flipdot/door/hardware/pihat_door.kicad_pcb

## KiCad design hardware/pihat_door.kicad_pcb (2018-01-24)

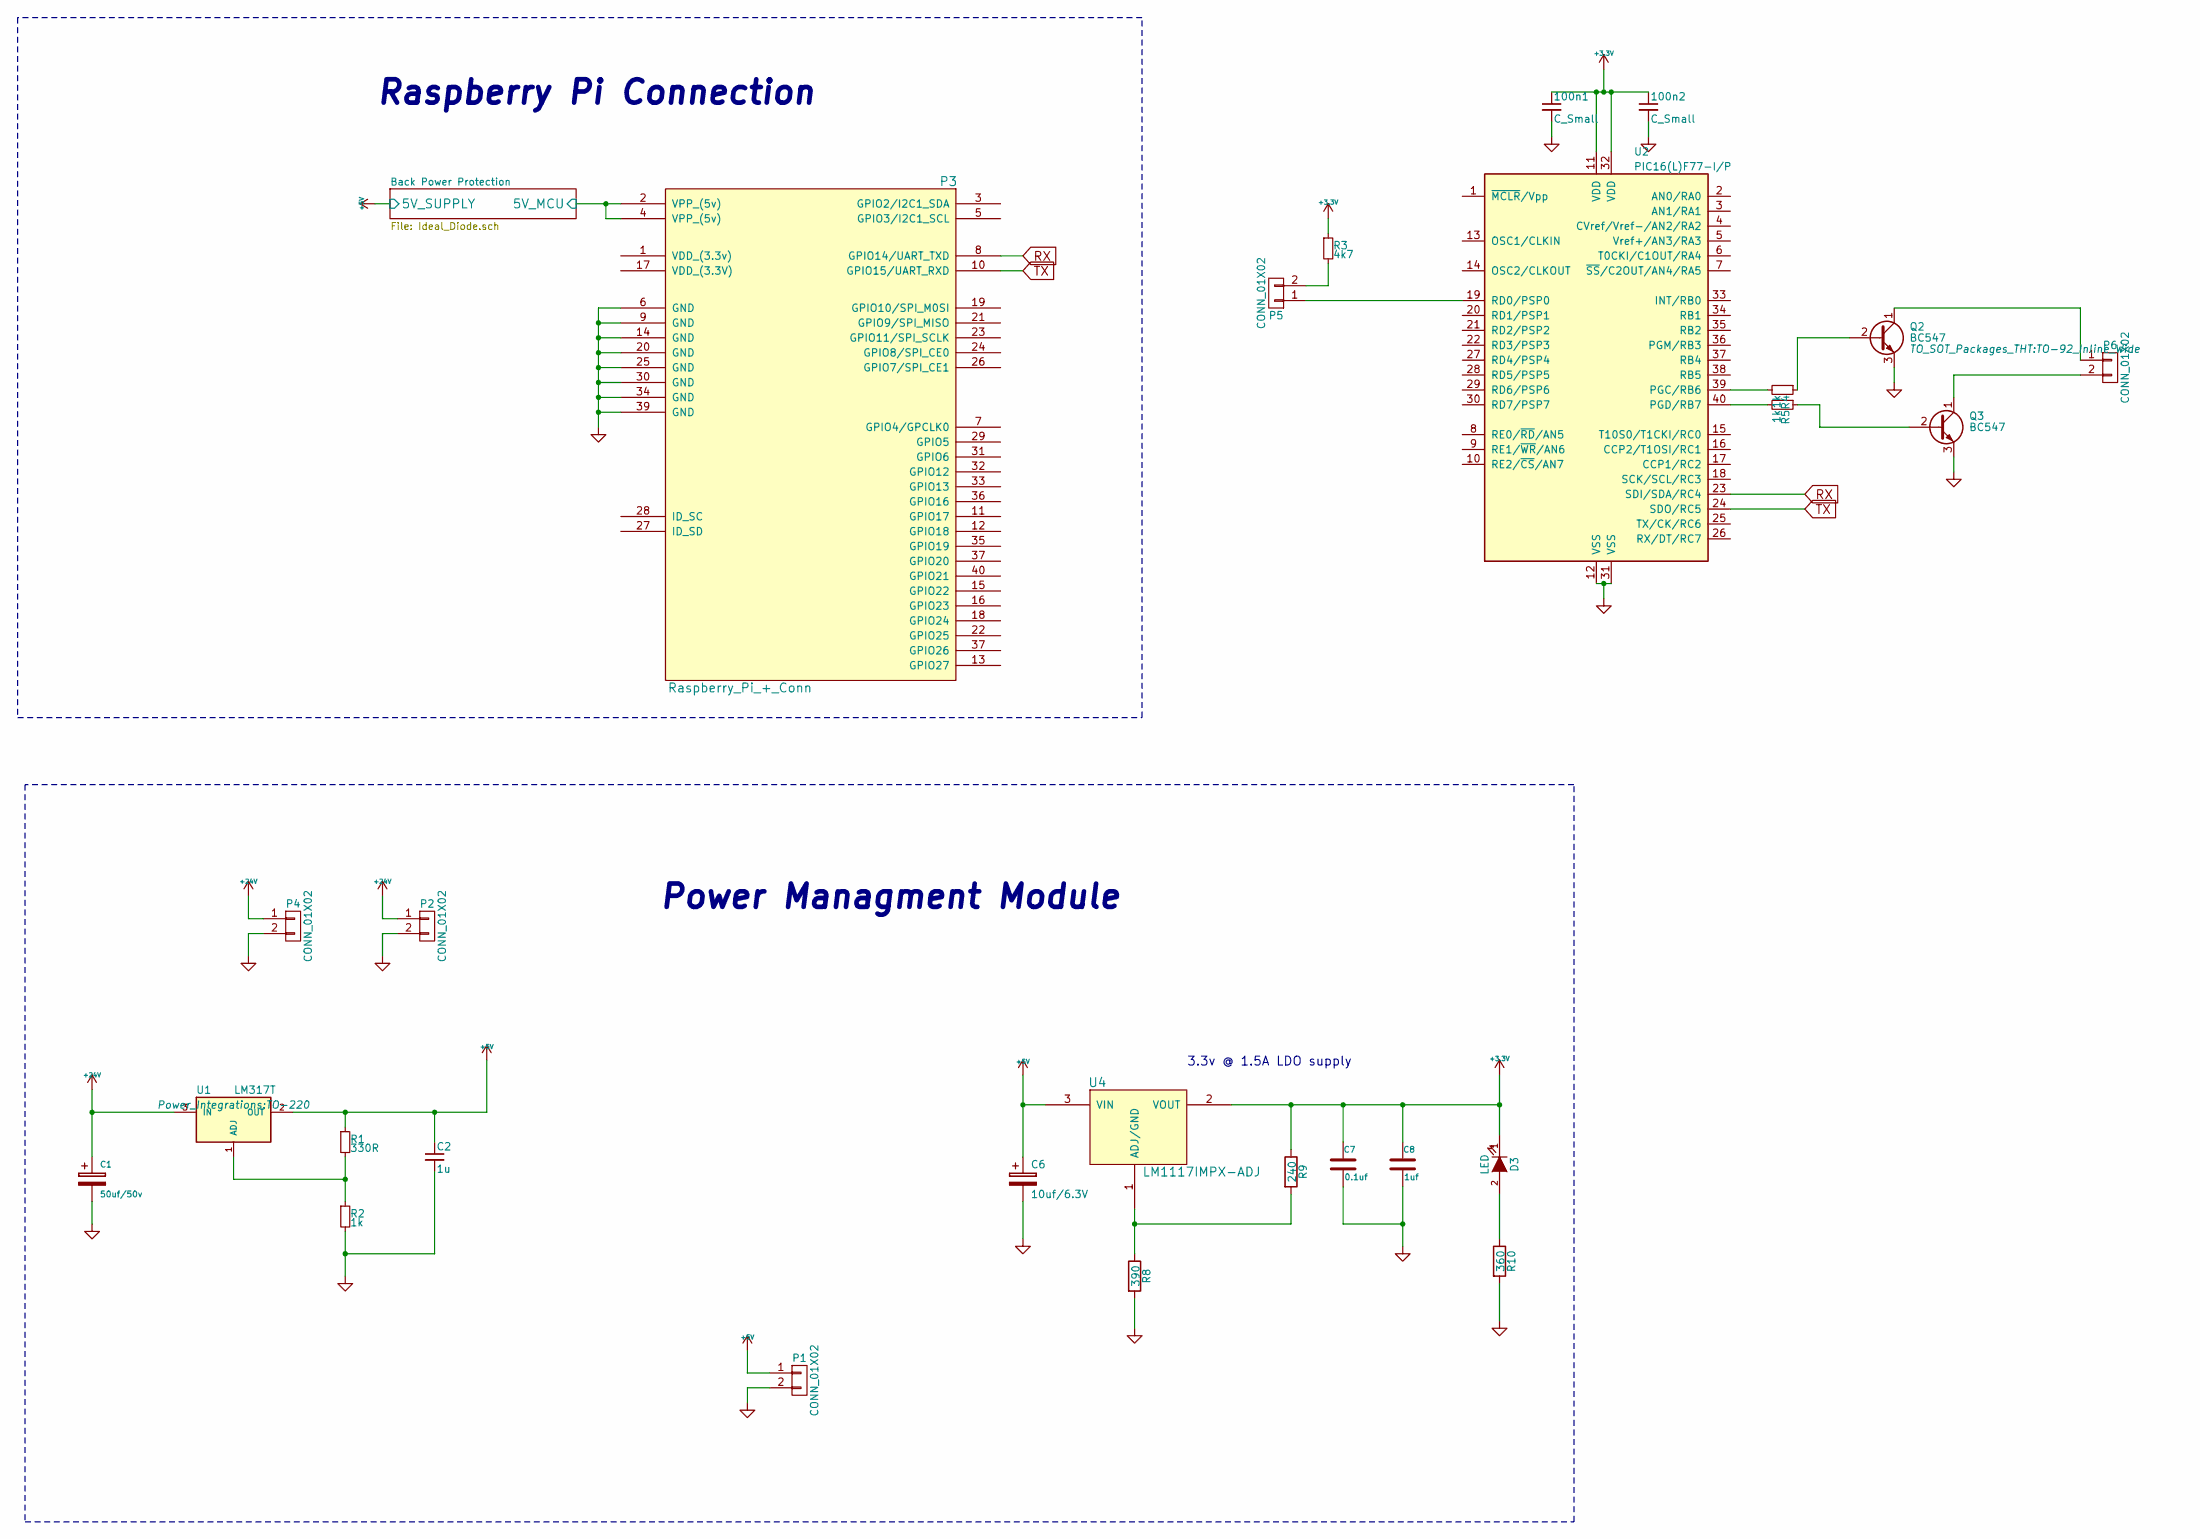
[picture p1: schematic pihat_door.sch]

Parts:
100n1, 100n2: C_Small; C_0805_HandSoldering
C1: 50uf/50v; c_elec_6.3x7.7; Mouser Part No. 647-UUR1H470MCL6GS
C2: 1u; c_elec_6.3x7.7
C6: 10uf/6.3V; c_elec_6.3x7.7; Mouser Part No. 5985-AVS16V100-F
C7: 0.1uf; C_0805_HandSoldering; Mouser Part No. 810-C1005X5R1H104K
C8: 1uf; C_0805_HandSoldering; Mouser Part No. 810-C1005X5R1H104K
D3: LED; LED-3MM; Mouser Part No. 743-HT-191USD
P1, P5, P6: CONN_01X02; AK300-2
P2, P4: CONN_01X02; PINHEAD1-2; Mouser Part No. 651-1904383
P3: Raspberry_Pi_+_Conn; IDC_Header_Straight_40pins; Mouser Part No. 517-30340-6002
Q2, Q3: BC547; TO-92_Inline_Wide
R1: 330R; R_0805_HandSoldering
R2, R4, R5: 1k; R_0805_HandSoldering
R3: 4k7; R_0805_HandSoldering
R8: 390; R_0805_HandSoldering; Mouser Part No. 594-MCT06030C3900FP5
R9: 240; R_0805_HandSoldering; Mouser Part No. 754-RR0816P-241D
R10: 360; R_0805_HandSoldering; Mouser Part No. 71-CRCW0603316RFKEB
U1: LM317T; TO-220
U2: PIC16(L)F77-I/P; DIP-40_W15.24mm
U4: LM1117IMPX-ADJ; TO-220; Mouser Part No. 926-M1117IMPXADJNOPB

Connections:
+3V3: 100n1.1, 100n2.1, C7.1, C8.1, D3.1 (K), R3.1, R9.1, U2.11 (VDD), U2.32 (VDD), U4.2 (VOUT)
+5V: C2.1, C6.1, P1.1, R1.1, U1.2 (OUT), U4.3 (VIN); also elsewhere on the board
+24V: C1.1, P2.1, P4.1, U1.3 (IN)
/Back Power Protection/5V_MCU: P3.2 (VPP_(5v)), P3.4 (VPP_(5v)); also elsewhere on the board
GND: 100n1.2, 100n2.2, C1.2, C2.2, C6.2, C7.2, C8.2, P1.2, P2.2, P3.6 (GND), P3.9 (GND), P3.14 (GND), P3.20 (GND), P3.25 (GND), P3.30 (GND), P3.34 (GND), P3.39 (GND), P4.2, Q2.3 (E), Q3.3 (E), R2.2, R8.2, R10.2, U2.12 (VSS), U2.31 (VSS); also elsewhere on the board
unnamed: D3.2 (A), R10.1
unnamed: P5.1, U2.19 (RD0/PSP0)
unnamed: P5.2, R3.2
unnamed: P6.1, Q2.1 (C)
unnamed: P6.2, Q3.1 (C)
unnamed: Q2.2 (B), R4.1
unnamed: Q3.2 (B), R5.1
unnamed: R1.2, R2.1, U1.1 (ADJ)
unnamed: R4.2, U2.39 (PGC/RB6)
unnamed: R5.2, U2.40 (PGD/RB7)
unnamed: R8.1, R9.2, U4.1 (ADJ/GND)
RX: P3.8 (GPIO14/UART_TXD), U2.23 (SDI/SDA/RC4)
TX: P3.10 (GPIO15/UART_RXD), U2.24 (SDO/RC5)

Notes on the sheet:
Raspberry Pi Connection
Power Managment Module
3.3v @ 1.5A LDO supply

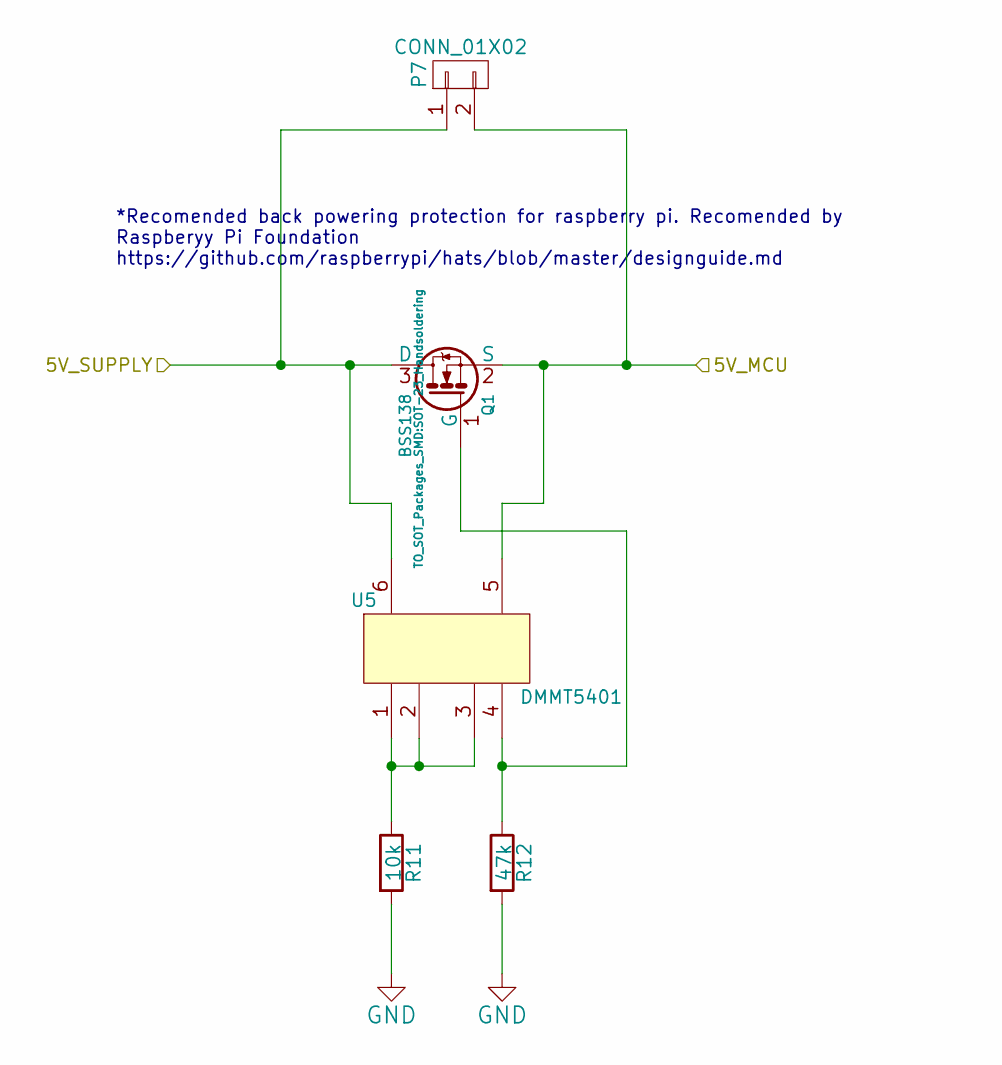
[picture p2: schematic Ideal_Diode.sch]

Parts:
P7: CONN_01X02; PINHEAD1-2
Q1: BSS138; SOT-23_Handsoldering; Mouser Part No. 621-DMG2305UX-13
R11: 10k; R_0805_HandSoldering; Mouser Part No. 71-CRCW0402-10K-E3
R12: 47k; R_0805_HandSoldering; Mouser Part No. 667-ERJ-2RKF4702X
U5: DMMT5401; SOT-23-6; Mouser Part No. 621-DMMT5401-7-F

Connections:
+5V: P7.1, Q1.3 (D), U5.6; also elsewhere on the board
/Back Power Protection/5V_MCU: P7.2, Q1.2 (S), U5.5; also elsewhere on the board
GND: R11.2, R12.2; also elsewhere on the board
unnamed: Q1.1 (G), R12.1, U5.4
unnamed: R11.1, U5.1, U5.2, U5.3

Notes on the sheet:
*Recomended back powering protection for raspberry pi. Recomended by Raspberyy Pi Foundation https://github.com/raspberrypi/hats/blob/master/designguide.md

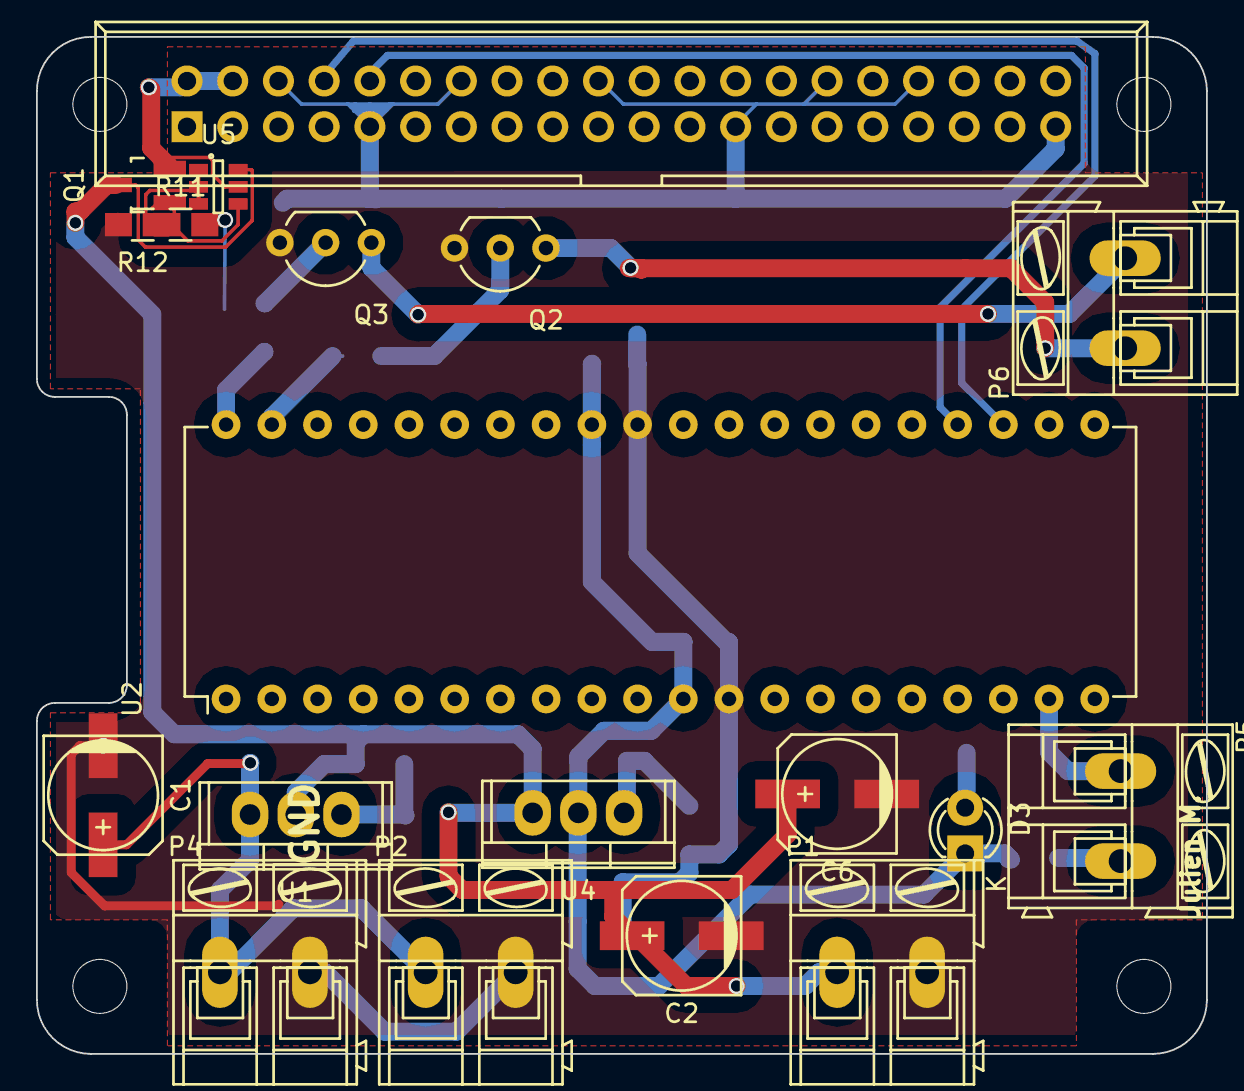
[picture p3: board pihat_door.kicad_pcb from above]

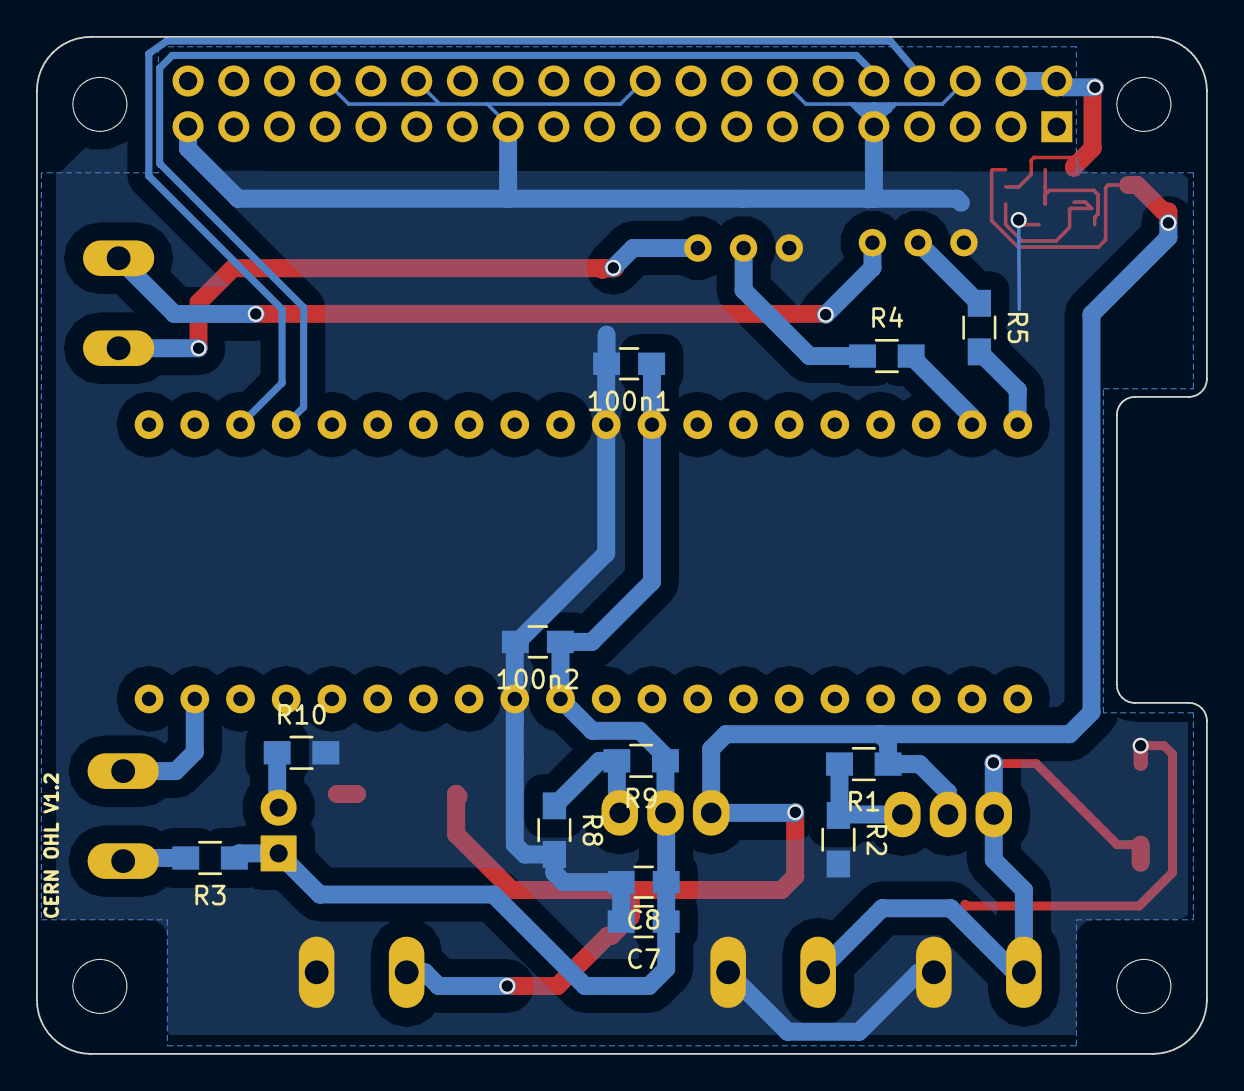
[picture p4: board pihat_door.kicad_pcb from below]

Board: 2 copper layers, 65.0 x 56.5 mm, 31 parts (12 on the bottom side), 20 nets.
