flipdot/door/(threads)

Thread 1 (2017-09-16):

Doorlock only unlocks

cfstras, 2017-09-16:
Dear maintainer,
das Tuerschloss wollte nur zuschliessen. Dann haben wir es neugestartet. Jetzt schliesst es nur noch auf.

malled2002, 2017-09-24:
fixed. Vermutlich nen Wackelkontakt?

Closed 2017-09-24.
