flipdot/door/acme.py

#!/usr/bin/python2
import logging
import os
import re
import ssl
import subprocess
import threading
import time

import config

acme_sh = ["./acme.sh/acme.sh"]

log = logging.getLogger(__name__)

class ACME(object):
    def __init__(self, app, staging=True):
        log.info("preparing ACME for %s", config.DOMAIN)
        if staging:
            if "--staging" not in acme_sh:
                acme_sh.append("--staging")
        else:
            if "--staging" in acme_sh:
                acme_sh.remove("--staging")

        self.account_thumb = self.get_account()
        self.app = app
        app.route('/.well-known/acme-challenge/<challenge>')(
            self.handle_challenge)

        self.context = ssl.SSLContext(ssl.PROTOCOL_TLSv1_2)
        self.https_thread = None
        self.try_load_cert()
        self.thread = threading.Thread(target=self.run)
        self.thread.daemon = True
        self.do_run = True
        self.cond = threading.Condition()
        self.thread.start()

    def stop(self):
        self.do_run = False
        self.cond.acquire()
        self.cond.notify_all()
        self.cond.release()

    def cert_paths(self):
        base_path = "%s/.acme.sh/%s" % (os.getenv("HOME"), config.DOMAIN)
        cert = "%s/fullchain.cer" % base_path
        key = "%s/%s.key" % (base_path, config.DOMAIN)
        return cert, key

    def try_load_cert(self):
        cert, key = self.cert_paths()
        log.debug("Cert: %s; %s", cert, key)
        try:
            self.context.load_cert_chain(cert, key)
            self.start_https()
        except IOError as e:
            log.warning("No cert file (yet): %s %s", repr(e), e.filename)

    def run(self):
        # wait for flask to start up
        time.sleep(3)
        while self.do_run:
            self.issue_cert()

            self.cond.acquire()
            self.cond.wait(60*60)
            self.cond.release()

    def start_https(self):
        if not self.https_thread:
            self.https_thread = threading.Thread(target=self.run_https)
        if not self.https_thread.is_alive():
            try:
                self.https_thread.start()
            except RuntimeError as e:
                if "started once" in e.message:
                    log.info("Restarting https...")
                    self.https_srv.shutdown()
                    self.https_thread.join()
                    self.https_thread = None
                    self.start_https()


    def run_https(self):
        from werkzeug.serving import make_server
        self.https_srv = make_server("0.0.0.0", config.HTTPS_PORT, self.app,
            threaded=True, processes=0, passthrough_errors=True,
            ssl_context=self.context)
        log.info("Running at https://%s:%d/", config.DOMAIN, config.HTTPS_PORT)
        self.https_srv.serve_forever()

    def handle_challenge(self, challenge):
        full = challenge + "." + self.account_thumb
        return full

    def get_account(self):
        try:
            out = sh(acme_sh + ["--register-account", "--accountemail", config.EMAIL])
        except ACMEError as e:
            e.message = "Registering account. " + e.message
            raise e
        log.debug("register account: %s", out)
        for match in re.finditer(r"ACCOUNT_THUMBPRINT='([^']+)'", out):
            c = match.group(1)
            log.debug("Challenge: %s", c)
            return c
        raise ACMEError("no thumprint found. output was: %s", out)


    def issue_cert(self):
        try:
            out = sh(acme_sh + ["--renew", "--stateless", "-d", config.DOMAIN])
        except ACMEError as e:
            if "Skip, Next renewal time is" in e.output:
                logging.info("Cert is up-to date, renewal: %s",
                    e.output.split("renewal time is: ")[1])
                return
            raise e
        if "not a issued domain" in out:
            out = sh(acme_sh + ["--issue", "--stateless", "-d", config.DOMAIN])
            log.info("issued cert: %s", out)
            self.try_load_cert()
            return
        # renewed cert TODO check output
        log.info("renewed cert: %s", out)
        self.try_load_cert()


def sh(argv):
    try:
        out = subprocess.check_output(argv, stderr=subprocess.STDOUT)
    except subprocess.CalledProcessError as e:
        raise ACMEError("exec %s [%d]: %s" % (argv, e.returncode, e.output), e)
    return out

class ACMEError(BaseException):
    def __init__(self, msg, base=None):
        super(ACMEError, self).__init__(msg, base)
        if isinstance(base, subprocess.CalledProcessError):
            self.returncode = base.returncode
            self.output = base.output
        else:
            self.output = None
            self.returncode = None
