flipdot/door/(commit log)

2018-01-24 add hardware schematic and layout files
    [Ideal_Diode.sch, pihat_door.kicad_pcb, pihat_door.sch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]
2018-01-24 fix of by on error
    [main.c]
2018-01-25 add mqtt endpoint. replace shell by python script
    [door.py, mqtt2door.py]
2018-02-21 Fix door webinterface with everything!
    [acme.py, web.py]
2026-10-27 fix(web): disable Flask debug mode
    Debug mode exposes the interactive Werkzeug debugger on any
    unhandled exception, and its PIN can be derived from machine
    information on an exposed host. Errors are now logged instead of
    serving a debugger.
2026-10-27 docs: point to the current flipdoor project
