flipdot/door/(notices)

Notices in the files:
hardware/pihat_door.kicad_pcb:
License: CERN OHL V1.2
CERN OHL V1.2
